joudoq/Experimental-Assessment-of-Non-Contact-Sensing-Technologies-for-Remote-River-Level-Monitoring/ICTP Poster.pdf

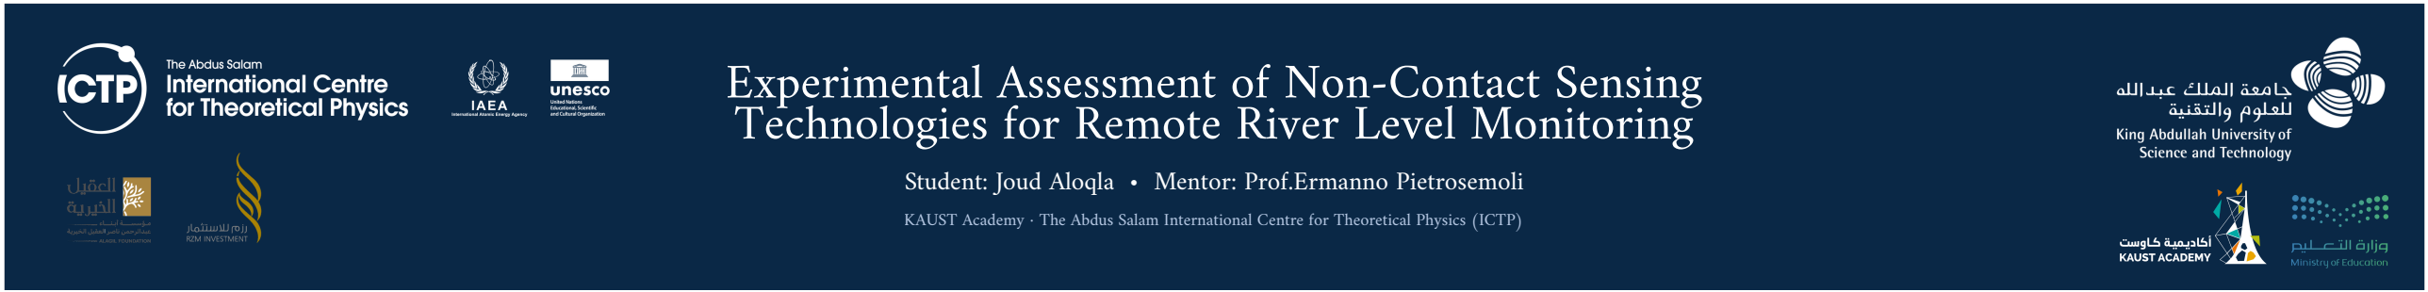
[picture p1: figure]

## Results

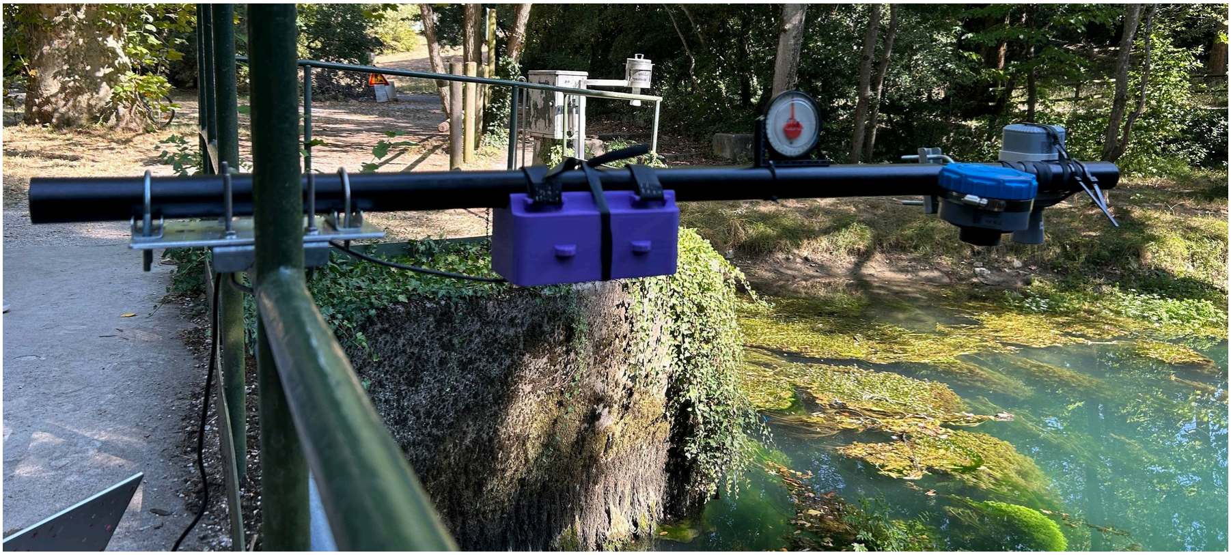
[picture p2: figure]
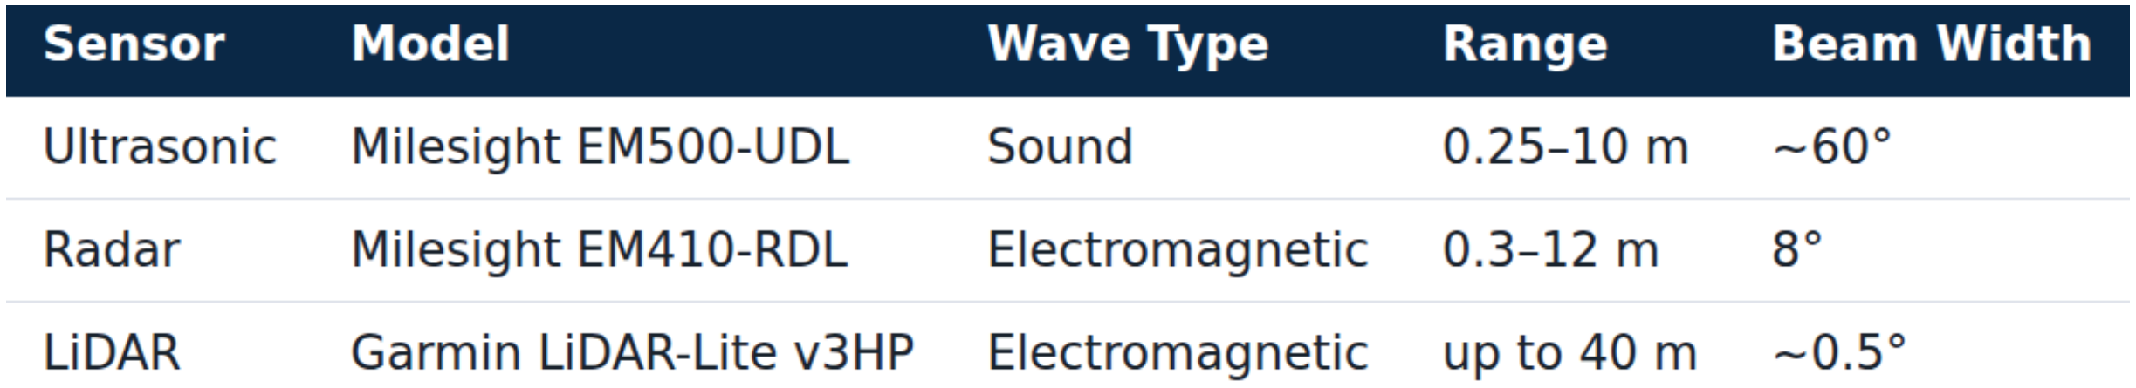
[picture p3: figure]

4

# Experimental Assessment of Non-Contact Sensing Technologies for Remote River Level Monitoring

KAUST Academy · The Abdus Salam International Centre for Theoretical Physics (ICTP)

## Introducion

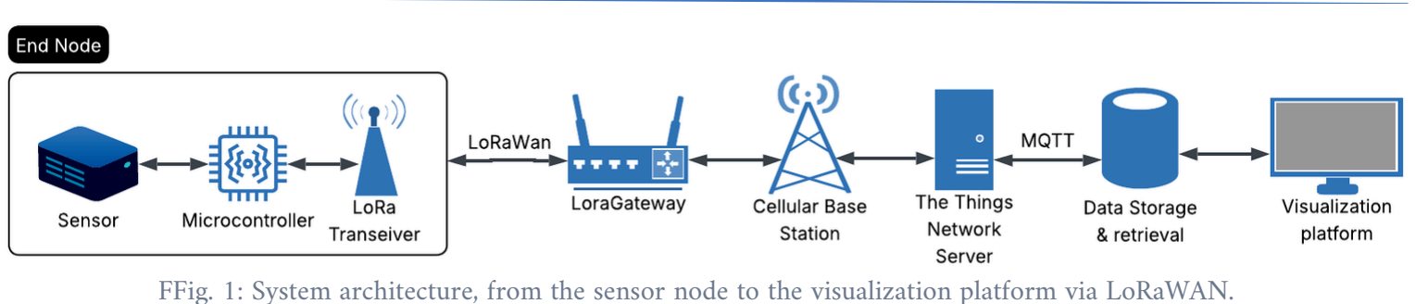
[picture p4: figure]

FFig. 1: System architecture, from the sensor node to the visualization platform via LoRaWAN.

River water level data is critical for flood warning and water resource management. But the rivers that need monitoring most are often in remote areas, without cellular coverage, and require a low-cost system that can run independently on limited battery power. This project builds a complete monitoring system using LoRaWAN for long-range, low- power data transmission, comparing three non-contact sensors (Ultrasonic, Radar, and LiDAR) for accuracy, performance, limitations, and overall reliability in remote river settings.

## Student: Joud Aloqla • Mentor: Prof.Ermanno Pietrosemoli

## Objectives

Evaluate and compare the performance of Ultrasonic, Radar, and LiDAR sensors under various field conditions.
Implement a robust communication architecture to transmit real-time data wirelessly from remote areas.
Optimize power consumption and extend battery life using a dynamic data transmission strategy.

## Methodology

### System Architecture

### Adaptive Transmission Strategy

The system dynamically adjusts the transmission interval based on river activity, maximizing the sleep interval when the water level is stable and increasing frequency during rapid changes, reducing power consumption and cost without missing critical flood data.

## Sensors

To evaluate sensor performance, a field experiment was conducted at the Timavo River, located in the Province of Trieste, Italy.

### Timavo River Experiment

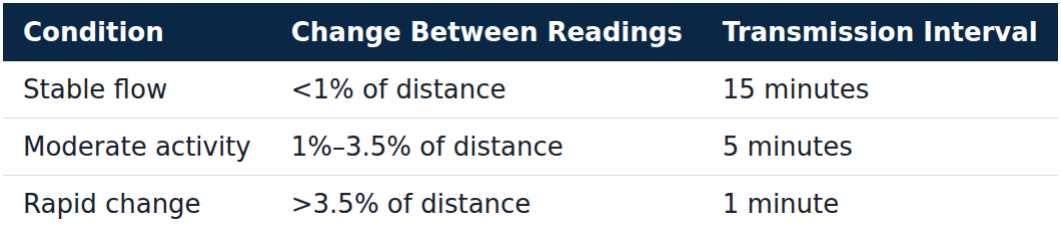
[picture p5: figure]

Table 1: Adaptive transmission intervals based on river activity level.

## Results

Fig. 5: Sensors Performance and Measurement Variations Over Time

All three sensors share the same working principle, each emits a pulse and measures how long it takes to reflect back from the water surface.

## Future work

## Referenses

Sensors were not tested under turbulent flow. Next step: repeat the trial during higher-flow or post-rainfall conditions, when accurate readings matter most for flood warning.
Battery and solar performance under the adaptive scheme were not evaluated. Next step: long-term field testing to assess power sustainability and reliability.
J. D. Paul, W. Buytaert, N. Sah,

"A Technical Evaluation of Lidar-Based Measurement of River Water Levels,

" Water
Resources Research 56.4 (2020), e2019WR026810.

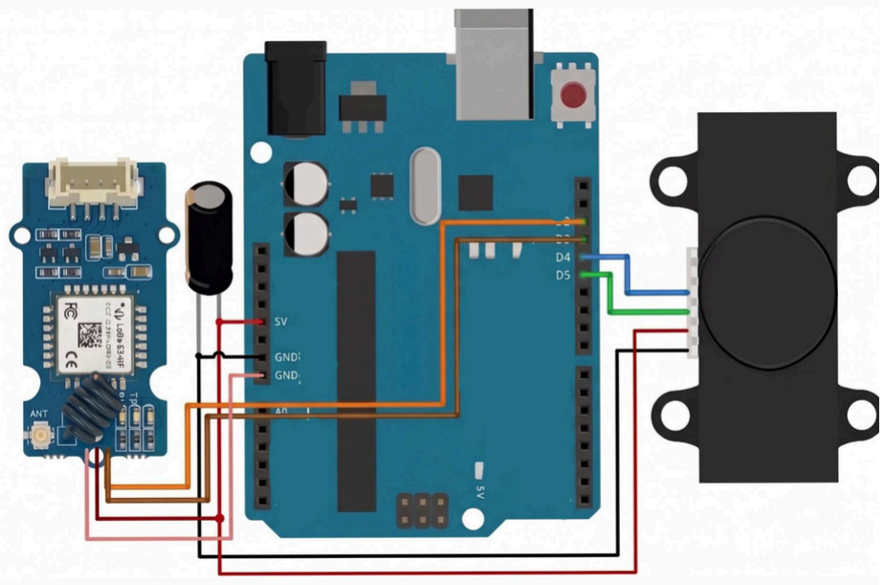
[picture p6: figure]
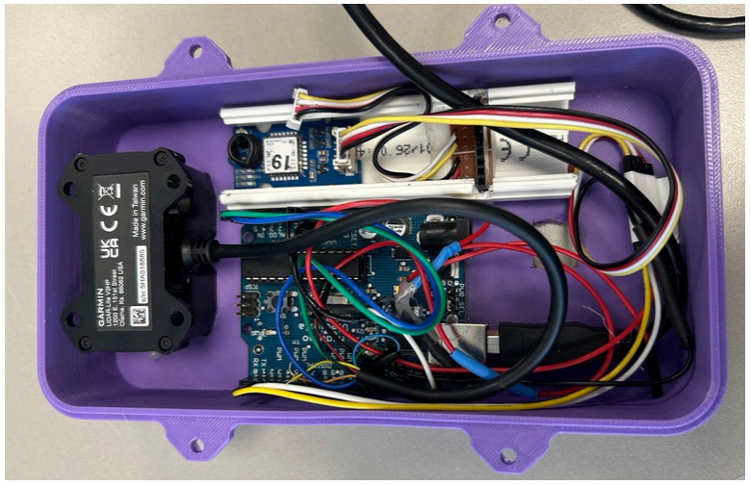
[picture p7: figure]

Fig. 4: Custom-built LiDAR node
J. N. Kabi et al.,

"Low cost, LoRa based river water level data acquisition system,

" HardwareX 14 (2023), e00414.

Table 2: Specifications of the tested sensors.

Fig. 2: Time-of-flight measurement principle

Radar : Delivered the most stable and repeatable readings when aligned within its 15° rated tilt range. Beyond this threshold, accuracy degraded sharply (~66.5% error).
Ultrasonic : Maintained high accuracy across the full tested tilt range (up to 30°); however, its wide beam increases sensitivity to false echoes from nearby structures, requiring a clear, obstruction-free installation zone.
LiDAR : Achieved the longest effective range, with accuracy improving in turbid water. In clear water, the narrow beam tends to penetrate the surface rather than reflect back, also making it more sensitive to surface changes and resulting in the highest measurement variation among the three sensors.

## Conclusion

Three non-contact sensors were evaluated and integrated into a complete LoRaWAN-based monitoring system with adaptive data transmission. Radar provided the highest precision, ultrasonic offered the greatest installation tolerance, and LiDAR achieved the longest range. These findings offer practical guidance for sensor selection and confirm that reliable, low-power flood monitoring is achievable in remote areas without cellular infrastructure.

Fig. 3: Field setup at the Timavo River, Trieste, Italy, with all three sensors mounted side by side.

Fig. 6: Average Distance Measured by Each Sensor at Different Tilt Angles
